luftek/pluto/f-91w.kicad_pcb

## KiCad design f-91w.kicad_pcb (2017-12-29)

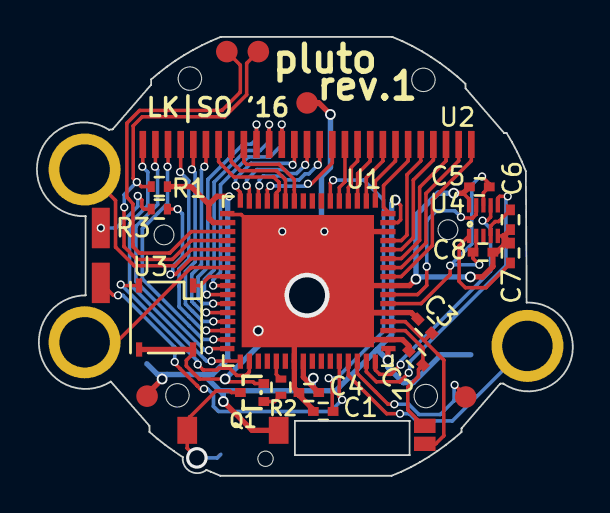
[picture p2: board f-91w.kicad_pcb from above]

Board: 2 copper layers, 29.8 x 24.4 mm, 37 parts (0 on the bottom side), 52 nets.

Parts:
C1: 4.7u; C_0402
C2, C3: 22p; C_0402
C4, C5, C6, C7, C8: 100n; C_0402
MH1, MH2, MH3, MH4, MH5, MH6, MH7: 1pin
P1, P2, P3, P4, P5, P6, P7, P8, P9, P10, P11, P13, P14, P15: CONN_01X01; 1pin
Q1: BC846; SOT416
R1, R3: 10k; R_0402
R2: 47k; R_0402
U1: MSP430FR6972; QFN-64-1EP_9x9mm_Pitch0.5mm
U2: LCD-F-91W
U3: TSOP57xxx
U4: MAG3110; DFN-10-1EP_2x2mm_Pitch0.4mm

Connections:
/BUZ: P9.1, Q1.3
/B_ALARM: P7.1, U1.45
/B_LIGHT: P5.1, U1.21
/B_MODE: P6.1, U1.23
/INT1: U1.55, U4.9
/IR: U1.24, U3.1
/IR_PWR: U1.34, U3.5
/LCD_COM1: U1.12, U2.7
/LCD_COM2: U1.11, U2.8
/LCD_COM3: U1.10, U2.9
/LCD_SEG1: U1.33, U2.1
/LCD_SEG2: U1.32, U2.2
/LCD_SEG3: U1.31, U2.3
/LCD_SEG4: U1.30, U2.4
/LCD_SEG5: U1.29, U2.5
/LCD_SEG6: U1.28, U2.6
/LCD_SEG7: U1.27, U2.10
/LCD_SEG8: U1.26, U2.11
/LCD_SEG9: U1.25, U2.12
/LCD_SEG10: U1.16, U2.13
/LCD_SEG11: U1.15, U2.14
/LCD_SEG12: U1.14, U2.15
/LCD_SEG13: U1.13, U2.16
/LCD_SEG14: U1.5, U2.17
/LCD_SEG15: U1.4, U2.18
/LCD_SEG16: U1.3, U2.19
/LCD_SEG17: U1.2, U2.20
/LCD_SEG18: U1.1, U2.21
/LCD_SEG19: U1.64, U2.22
/LCD_SEG20: U1.61, U2.23
/LCD_SEG21: U1.60, U2.24
/LCD_SEG22: U1.59, U2.25
/LCD_SEG23: U1.58, U2.26
/LCD_SEG24: U1.57, U2.27
/LED_1: P11.1, U1.44
/LED_2: R3.2, U1.22
/MAG_PWR: C5.2, C8.1, U1.54, U4.2, U4.8
/Q-1: C2.1, P1.1, U1.51
/Q-2: C3.1, P2.1, U1.52
/SCL: U1.48, U4.7
/SDA: U1.47, U4.6
GND: C1.2, C2.2, C3.2, C4.2, C5.1, C6.2, C7.2, C8.2, P13.1, Q1.2, U1.17, U1.39, U1.50, U1.53, U1.56, U1.62, U1.65, U3.6, U4.5, U4.10
unnamed: C1.1, U1.6
unnamed: C6.1, U4.4
unnamed: C7.1, U4.1
unnamed: P3.1, U1.19
unnamed: P4.1, R1.2, U1.20
unnamed: P10.1, R3.1
unnamed: P15.1, U1.46
unnamed: Q1.1, R2.2
unnamed: R2.1, U1.37
VCC: C4.1, P8.1, P14.1, R1.1, U1.18, U1.40, U1.49, U1.63
