luftek/pluto/(threads)

Thread 2 (2018-08-04):

KiCad v5 Migration

luftek, 2018-08-04:
Close this issue when you have succesfully migrated to Kicad v5.
Currently project uses Kicad v4.0.2-stable

Opening project should not report any errors.
